danjulio/blue_pot/pictures/phone_wiring.png

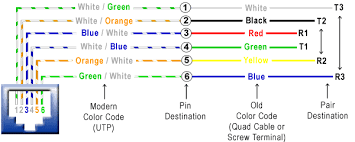
pictures/phone_wiring.png
