danjulio/blue_pot/eagle/blue_pot_proto_schem.pdf

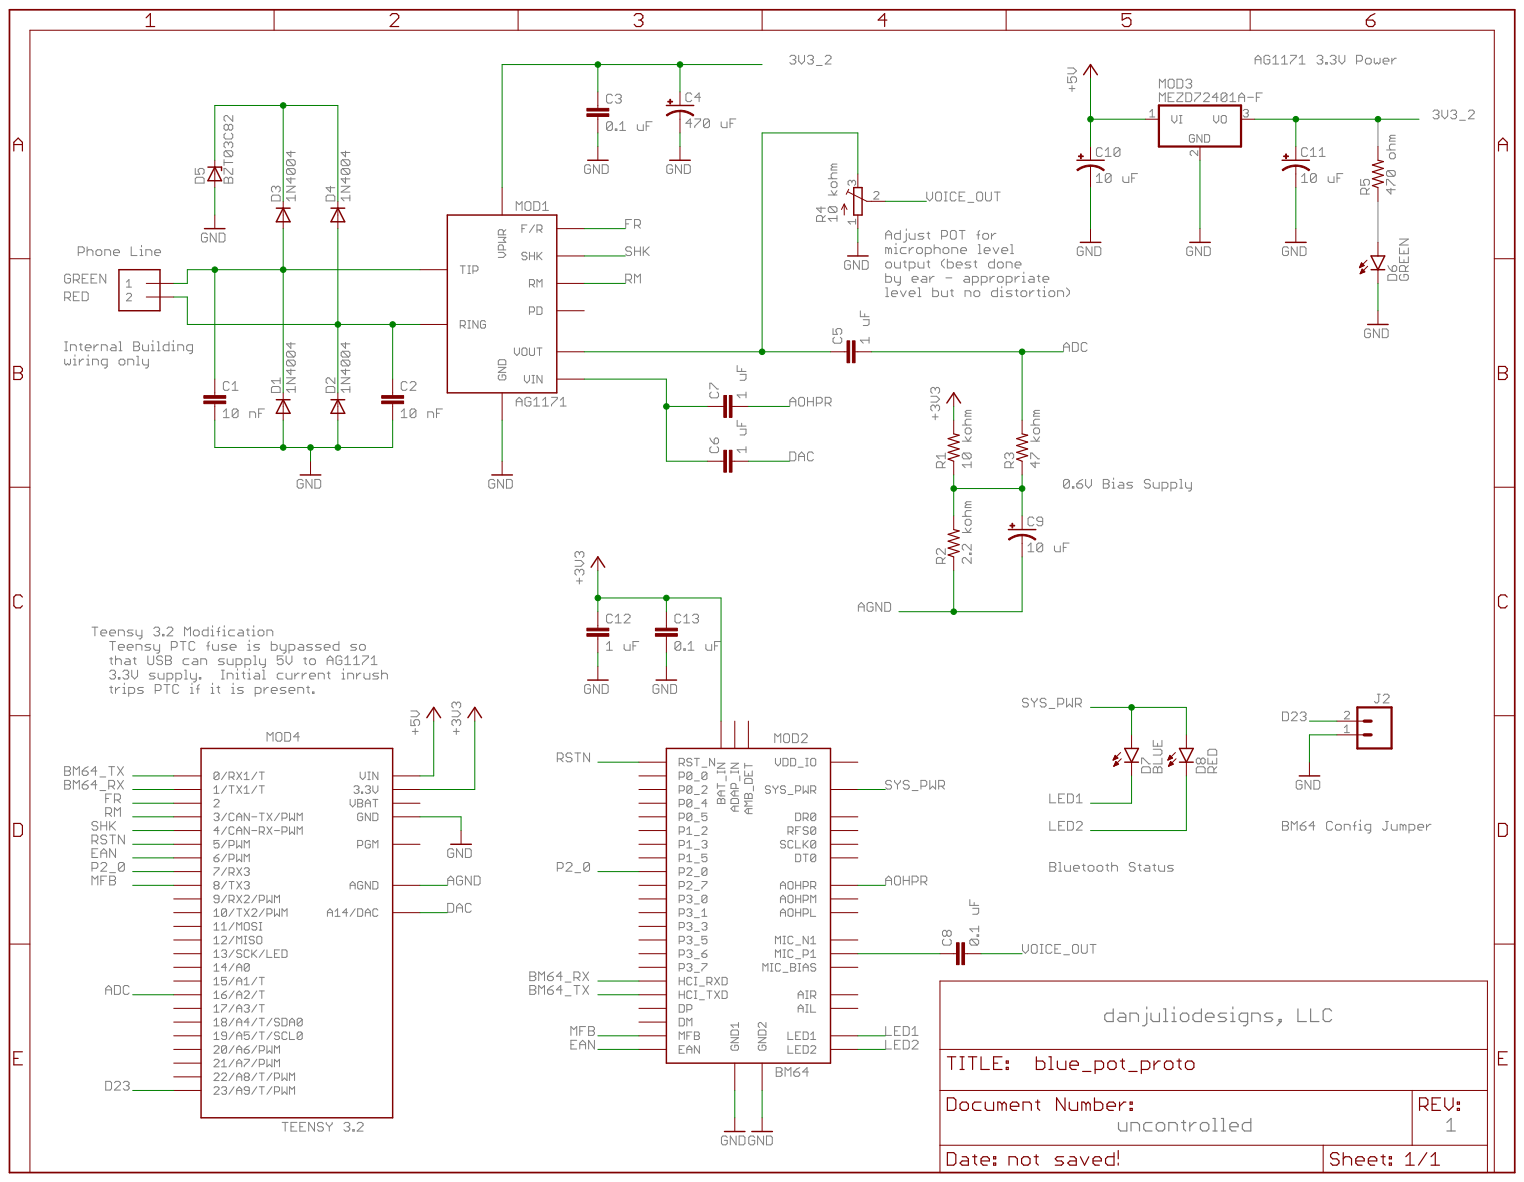
[picture p6: page 1]
