danjulio/blue_pot/eagle/blue_pot_proto.sch

## EAGLE design eagle/blue_pot_proto.sch (2019-06-29)

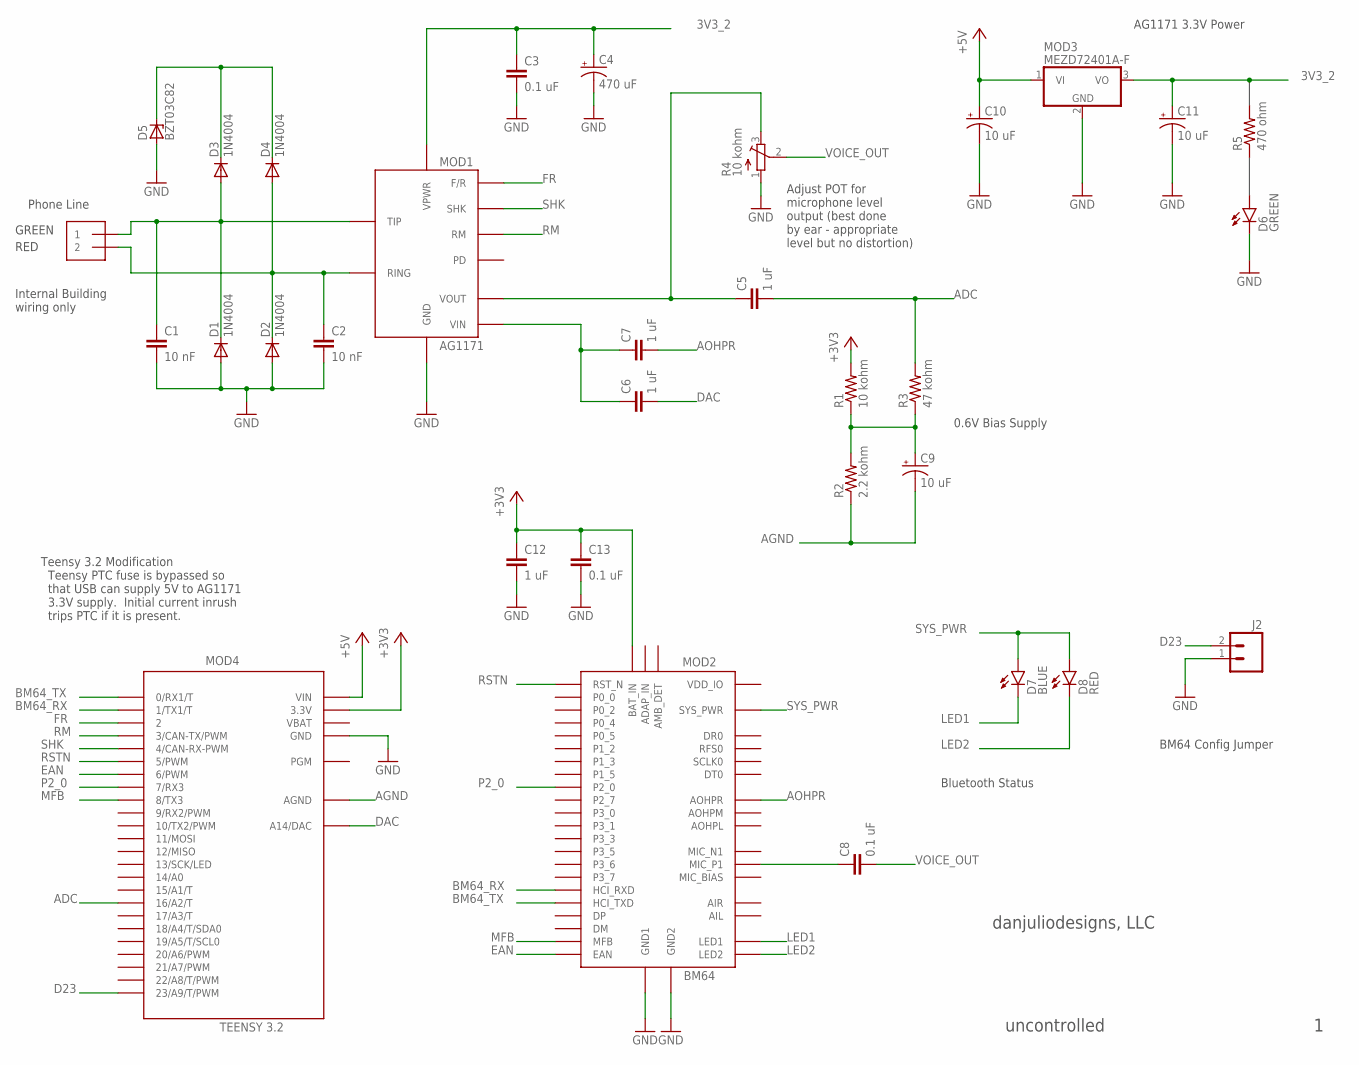
[picture p7: schematic blue_pot_proto.sch]

Parts:
C1, C2: 10 nF; C5B2.5
C3, C8, C13: 0.1 uF; C5B2.5
C4: 470 uF; TT5D10
C5, C6, C7, C12: 1 uF; C5B2.5
C9, C10, C11: 10 uF; TT2D5
D1, D2, D3, D4: 1N4004; DO41-10
D5: BZT03C82; SOD57Z10
D6: GREEN; LED5MM
D7: BLUE; LED5MM
D8: RED; LED5MM
J1: 1X2-3.5MM
J2: M02PTH; 1X02
MOD1: AG1171
MOD2: BM64
MOD3: MEZD72401A-F; TO220H
MOD4: TEENSY 3.2; TEENSY_3.0-3.2&LC_OUTER_ROW
R1: 10 kohm; 0207/10
R2: 2.2 kohm; 0207/10
R3: 47 kohm; 0207/10
R4: 10 kohm; TC33X
R5: 470 ohm; 0207/10

Connections:
3V3_2: C3.1, C4.+, C11.+, MOD1.P$13 (VPWR), MOD3.3 (VO)
+3V3: C12.1, C13.1, MOD2.22 (BAT_IN), MOD4.3.3V, R1.2
+5V: C10.+, MOD3.1 (VI), MOD4.VIN
ADC: C5.2, MOD4.16/A2 (16/A2/T), R3.2
AGND: C9.-, MOD4.AGND, R2.1
AOHPR: C7.2, MOD2.5 (AOHPR)
BM64_RX: MOD2.19 (HCI_RXD), MOD4.1 (1/TX1/T)
BM64_TX: MOD2.20 (HCI_TXD), MOD4.0 (0/RX1/T)
D23: J2.2, MOD4.23/A9 (23/A9/T/PWM)
DAC: C6.2, MOD4.RESET/DAC (A14/DAC)
EAN: MOD2.32 (EAN), MOD4.6 (6/PWM)
FR: MOD1.P$3 (F/R), MOD4.2
GND: C1.2, C2.2, C3.2, C4.-, C10.-, C11.-, C12.2, C13.2, D1.A, D2.A, D5.A, D6.K (C), J2.1, MOD1.P$12 (GND), MOD2.14 (GND1), MOD2.43 (GND2), MOD3.2 (GND), MOD4.GND, R4.1 (A)
LED1: D7.K (C), MOD2.28 (LED1)
LED2: D8.K (C), MOD2.27 (LED2)
MFB: MOD2.26 (MFB), MOD4.8 (8/TX3)
unnamed: C1.1, D1.C, D3.A, J1.1, MOD1.P$2 (TIP)
unnamed: C2.1, D2.C, D4.A, J1.2, MOD1.P$1 (RING)
unnamed: C8.1, MOD2.9 (MIC_P1)
unnamed: C6.1, C7.1, MOD1.P$9 (VIN)
unnamed: D3.C, D4.C, D5.C
unnamed: C5.1, MOD1.P$10 (VOUT), R4.3 (E)
unnamed: C9.+, R1.1, R2.2, R3.1
P2_0: MOD2.41 (P2_0), MOD4.7 (7/RX3)
RM: MOD1.P$4 (RM), MOD4.3 (3/CAN-TX/PWM)
RSTN: MOD2.13 (RST_N), MOD4.5 (5/PWM)
SHK: MOD1.P$5 (SHK), MOD4.4 (4/CAN-RX-PWM)
SYS_PWR: D7.A, D8.A, MOD2.24 (SYS_PWR)
VOICE_OUT: C8.2, R4.2 (S)

Notes on the sheet:
danjuliodesigns, LLC
uncontrolled
BM64 Config Jumper
Bluetooth Status
0.6V Bias Supply
AG1171 3.3V Power
Teensy 3.2 Modification Teensy PTC fuse is bypassed so that USB can supply 5V to AG1171 3.3V supply. Initial current inrush trips PTC if it is present.
GREEN
RED
Phone Line
Internal Building wiring only
Adjust POT for microphone level output (best done by ear - appropriate level but no distortion)
