danjulio/blue_pot/(commit log)

2019-07-03 Add image of Teensy to show PTC
2022-07-31 Fixed bug in configuring pins in passthrough mode.
    [blue_pot_proto.ino]
